yynmt/mozc-yunomi/README.md

# Gboard 湯呑みバージョン ◤◢◤◢◤◢◤◢カスタム

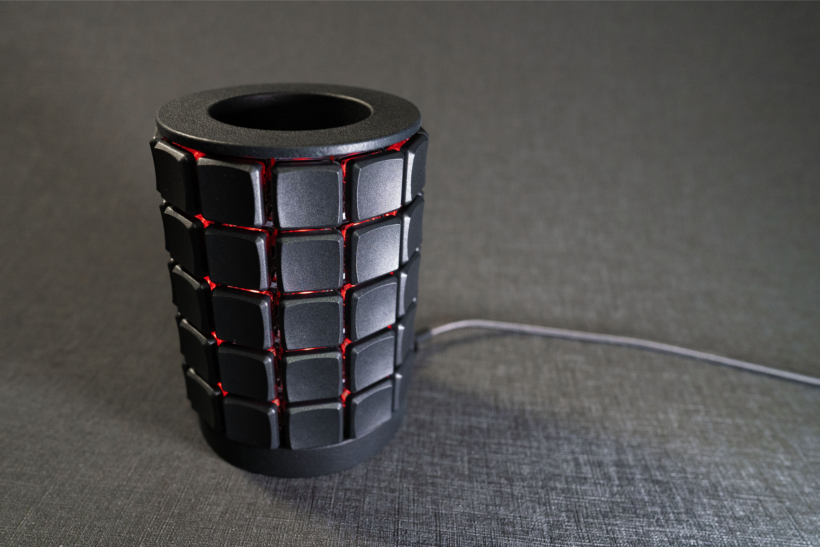
[picture p1: images/main.jpg]
mozc-yunomi_yynmt


- [ビルドガイド](/docs/buildguide_jp.md)
