yynmt/mozc-yunomi/case/jig.v1.step

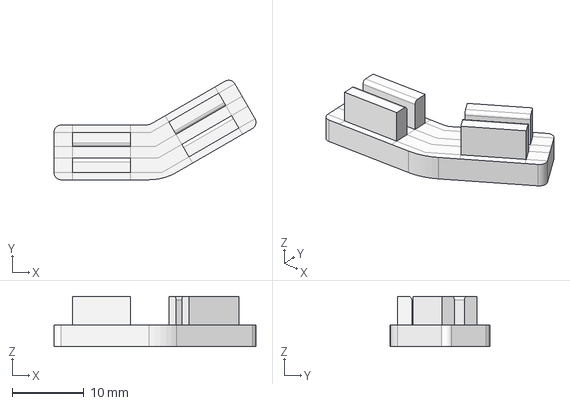
[picture p2: CAD file, 2022-09-18]
case/jig.v1.step
28.1 x 13.8 x 7.00 mm
