yynmt/mozc-yunomi/(list of files, cad)

Other CAD files:
case/jig.v1.stl
